tomsim/DivGMX/README.md

# DivGMX
Устройство расширения аппаратных возможностей ZX Spectrum и клонов

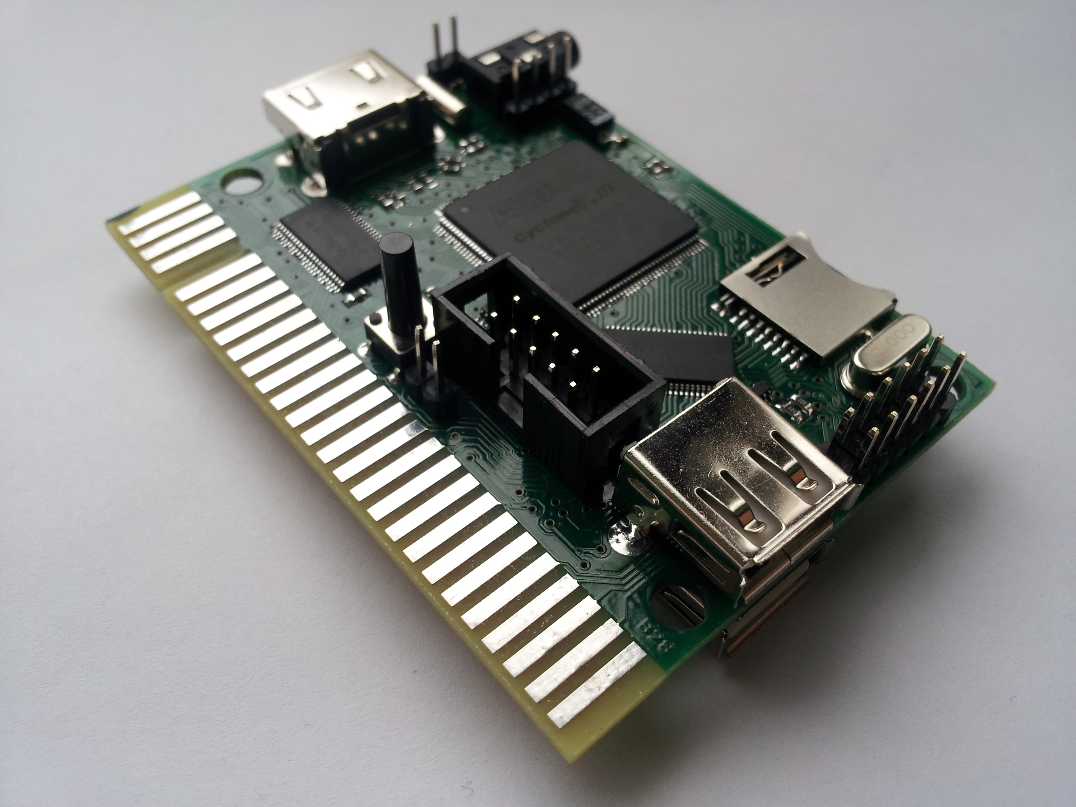
[picture p1: divgmx_board/images/divgmx_brd.png]


DivGMX представляет собой универсальное устройство для установки в слот ZX BUS и основанное на программируемой логической матрице (ПЛИС), обладает гибкой архитектурой, что позволяет проводить обновление и расширение аппаратных возможностей своего ZX Spectrum или клона простой заменой конфигурации.

####Назначение устройства:
- Удобство и комфорт от работы с новой периферией
- Простое подключение ZX Spectrum и его клонов к современному ТВ или монитору через HDMI
- Подключение USB клавиатуры
- Подключение USB мыши
- Подключение USB Gamepad
- Работа с файлами на microSD
- Расширение аппаратных возможностей без паяльника
- Расширение звуковых возможностей
- Расширение графических возможностей
- Обучение работы с ПЛИС
- Возможность создать своё уникальное устройство
- Возможность автономной работы
- Возможность объединения нескольких устройств
- Использование в системах промышленной автоматики
- Возможность подключения Shilds от Arduino через адаптер
- ...

####Спецификация:
- ПЛИС Altera Cyclone III EP3C10 (Cyclone III EP3C5/EP3C10 или Cyclone IV EP4CE6/EP4CE10)
- SDRAM 32MB х 8 bit (4/8/16/32MB х 8 bit)
- SPI FLASH 64Mb (16/32/64Mb)
- RTC DS1338Z
- HDMI
- VNC2 2x USB 2.0 Host контроллер (6 GPIO/SPI/V2Debug)
- microSD
- JTAG
- I2C
- Button NMI, RESET
- Аудио Stereo разъем
- Слот ZX-BUS
- Размер платы 74 х 54 мм

####Совместимость:
- ZX-BUS
- Nemo-BUS

####Возможность аппаратно воспроизвести:
- MSX
- NES
- Orion
- Pentagon 128K, 256K, 512K, 1024K
- Spetsialist_MX
- TS-Conf
- Vector 06cc
- ZX Spectrum 16K, 48К, 128К, +2, +2A, +2B, +3
- Башкирия 2М
- Львов
- Радио 86рк
- ЮТ-88
- ...

####Поддержка в конфигурациях:
- CMOS (стандарт Mr. Gluk)
- DivMMC
- DMA Ultra Sound Card
- Data-Gear
- Gamepad
- General Sound
- Kempston joystick
- Kempston mouse
- Multiface
- ZX Interface 2
- SounDrive
- Turbo Sound
- Z-Controller
...
