tomsim/DivGMX/divgmx_board/images/DivGMX_box.jpg

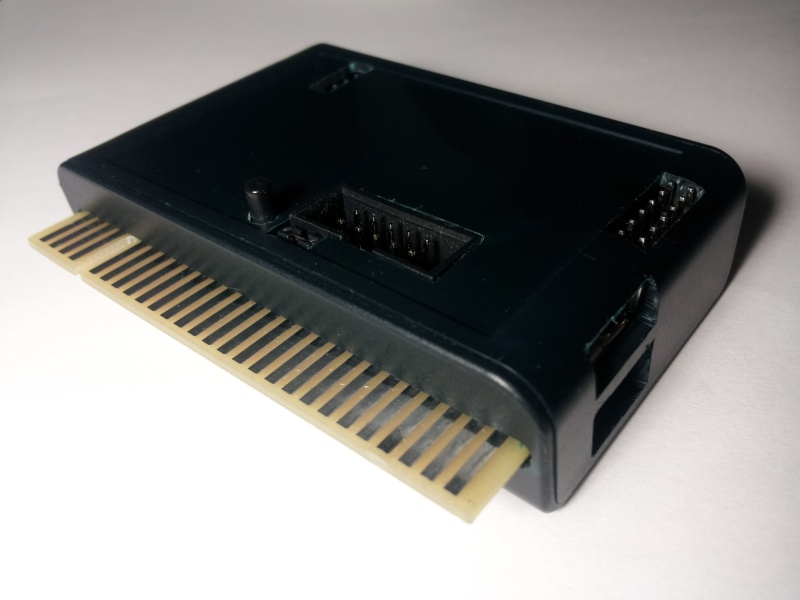
divgmx_board/images/DivGMX_box.jpg
