tomsim/DivGMX/divgmx_board/images/divgmx_sch_eagle.png

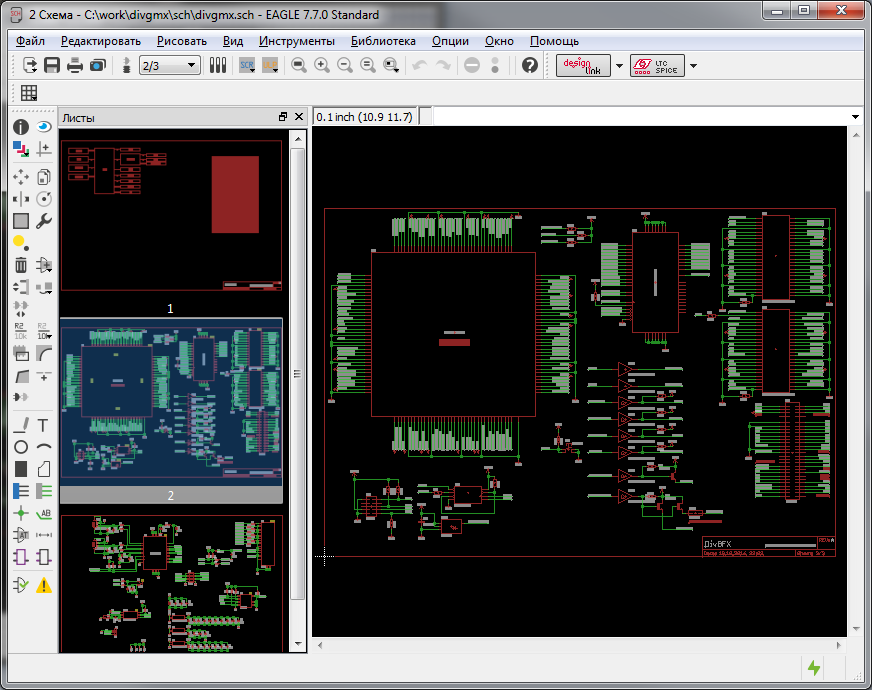
divgmx_board/images/divgmx_sch_eagle.png
