tomsim/DivGMX/divgmx_test_ram/README.md

# Тест 128К
Конфигурация для DivGMX, тестирующая ОЗУ 46К/128К ZX Spectrum и клонов.

Вывод A25 (X1) нужно изолировать (можно наклеить тонкую полоску скотча) и установить перемычку JP1 для возможности отключения ROM на плате ZXM-Phoenix 1024K REV01.
