tomsim/DivGMX/divgmx_board/manuals/divgmx_sch_rev_a.pdf

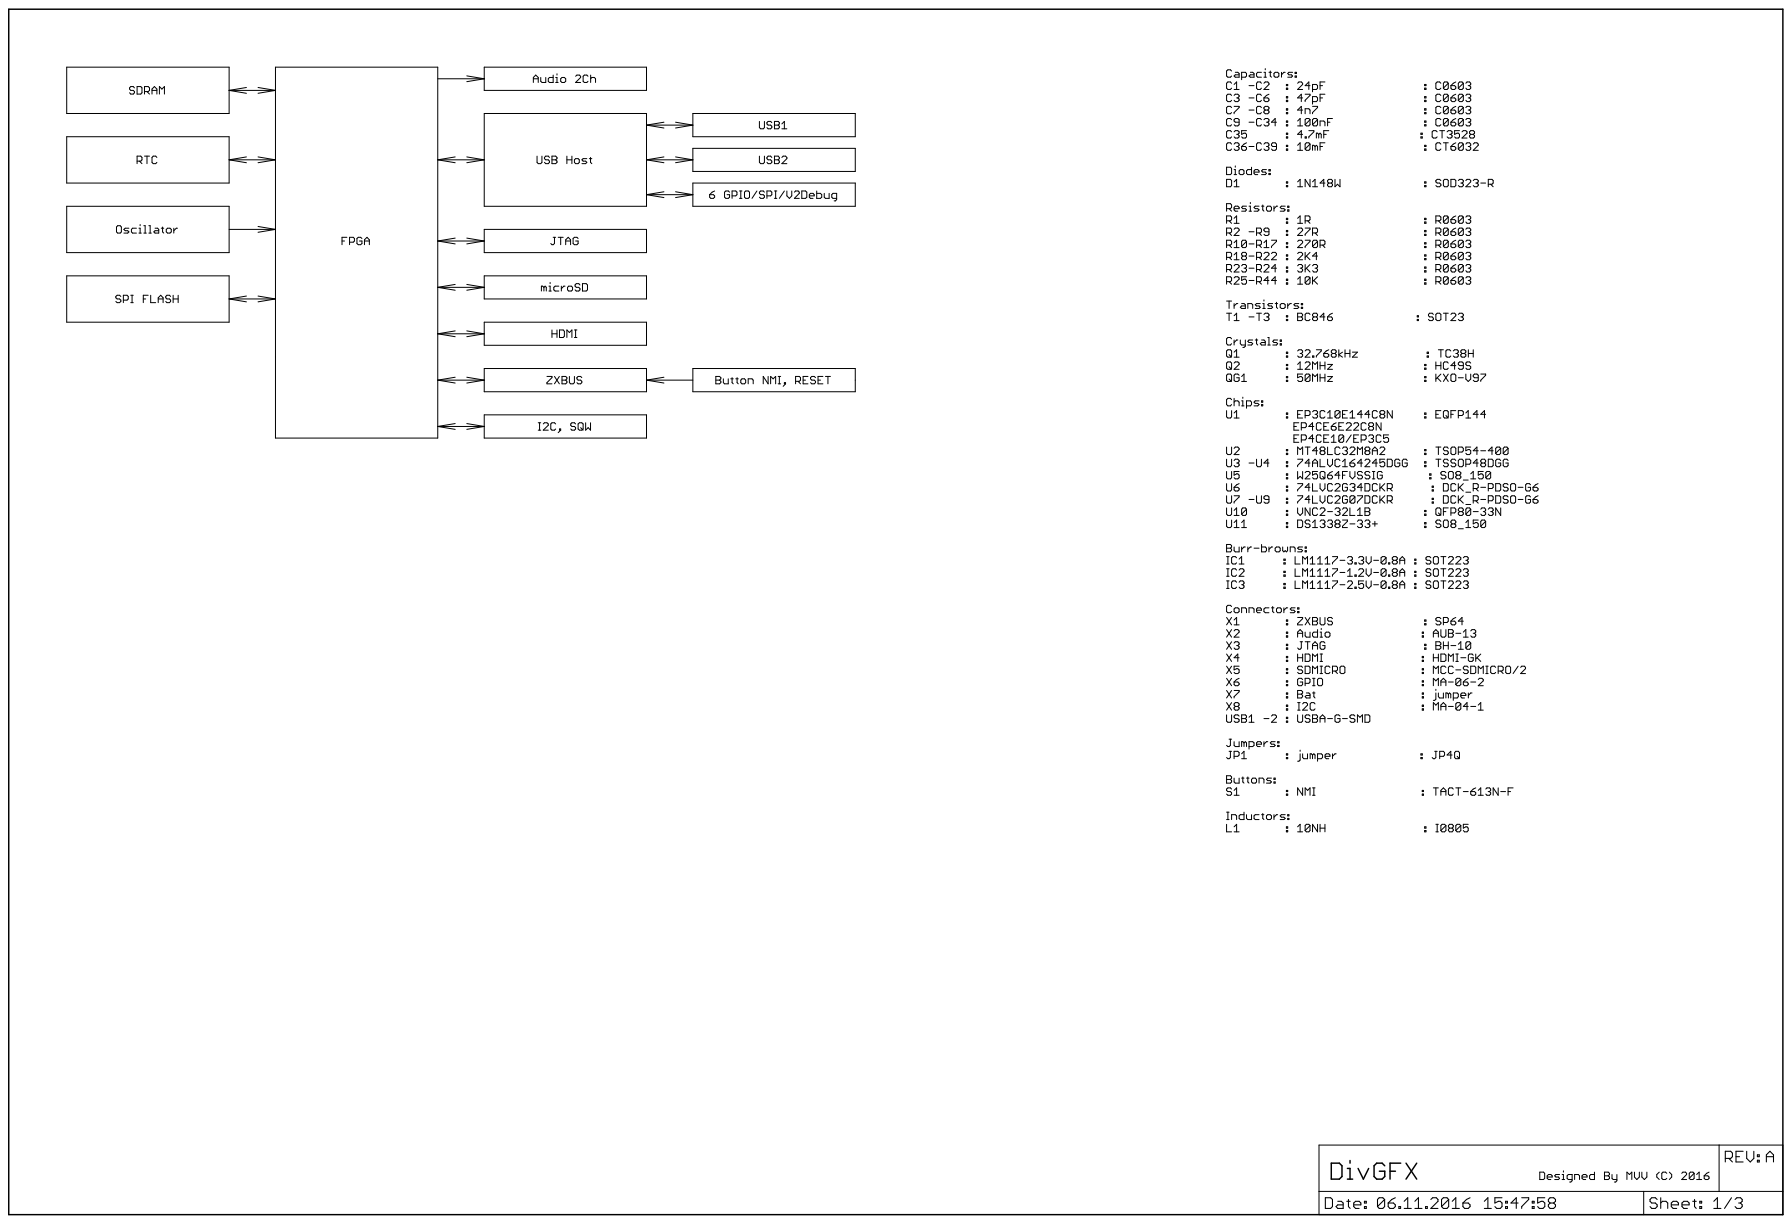
[picture p9: page 1]

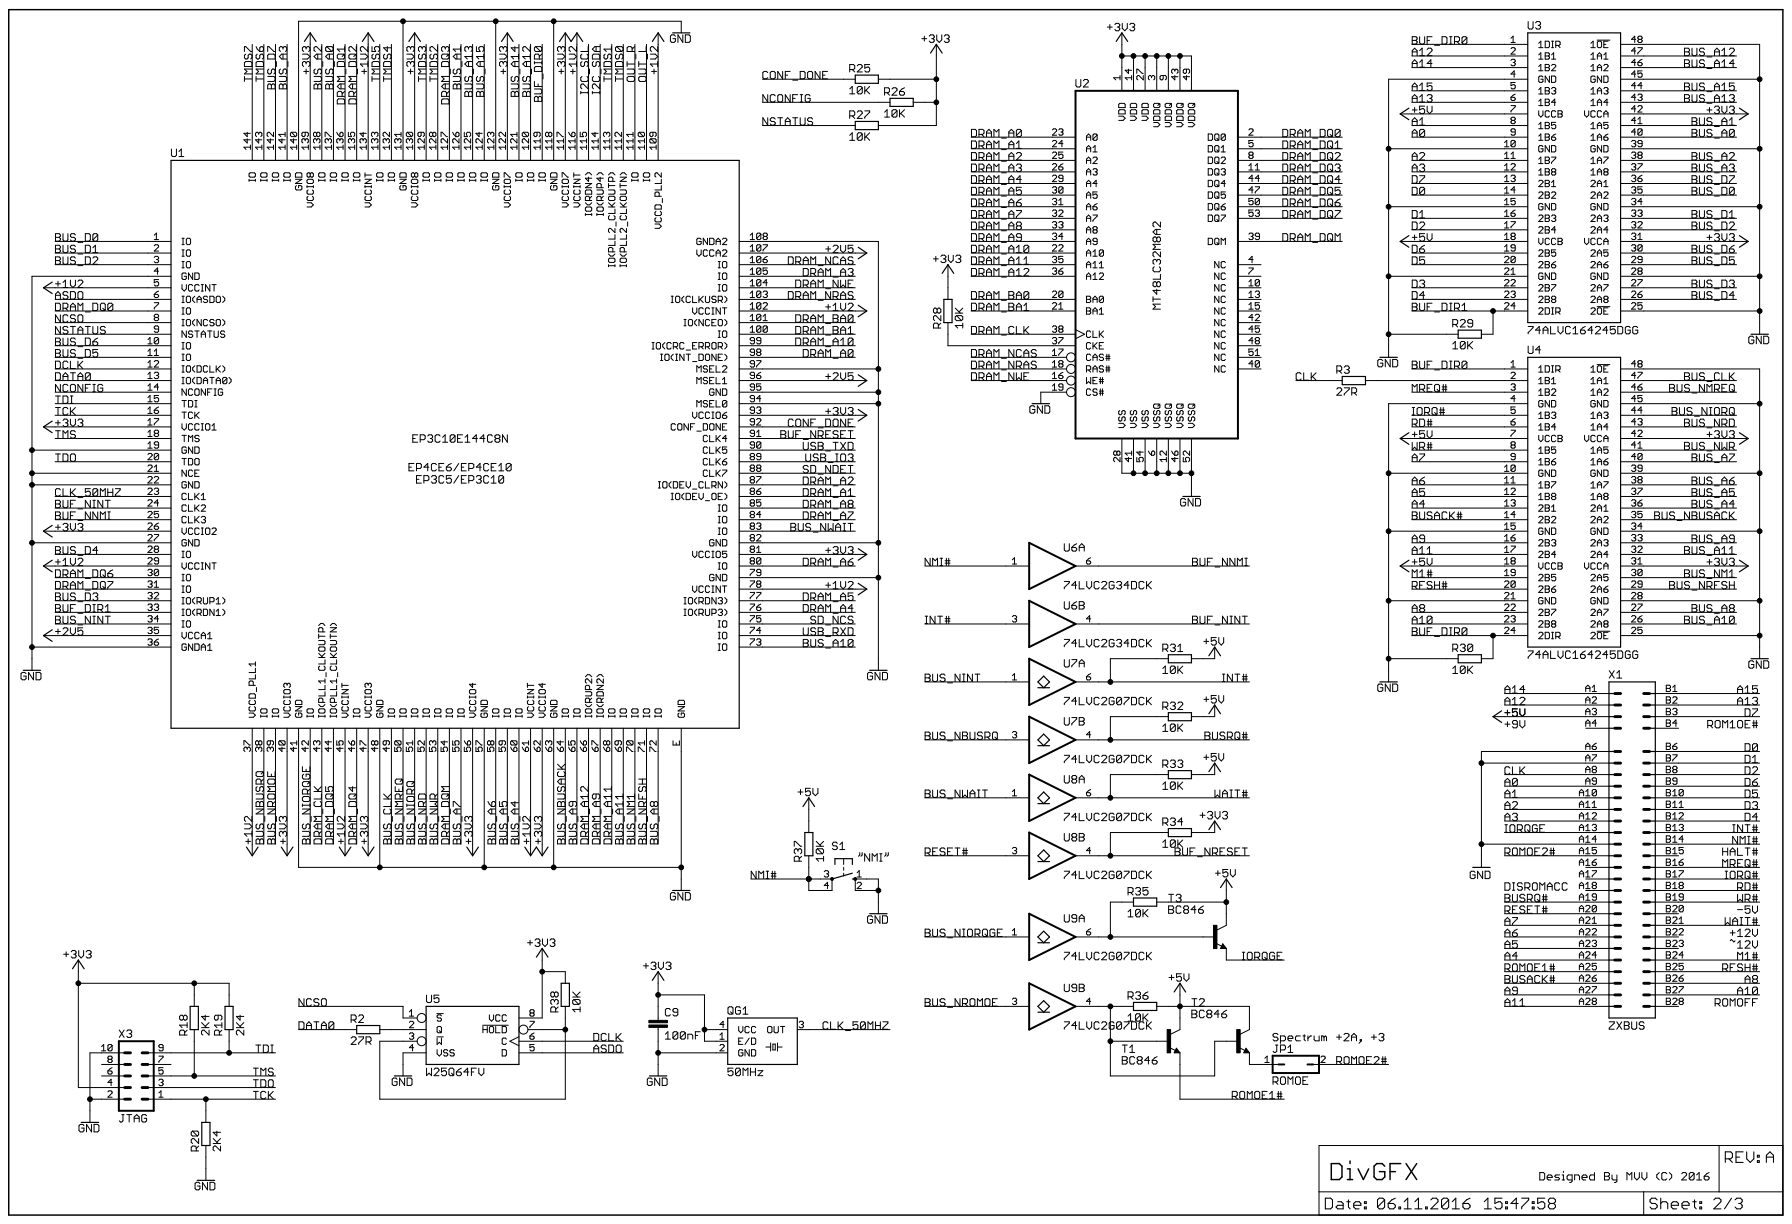
[picture p10: page 2]

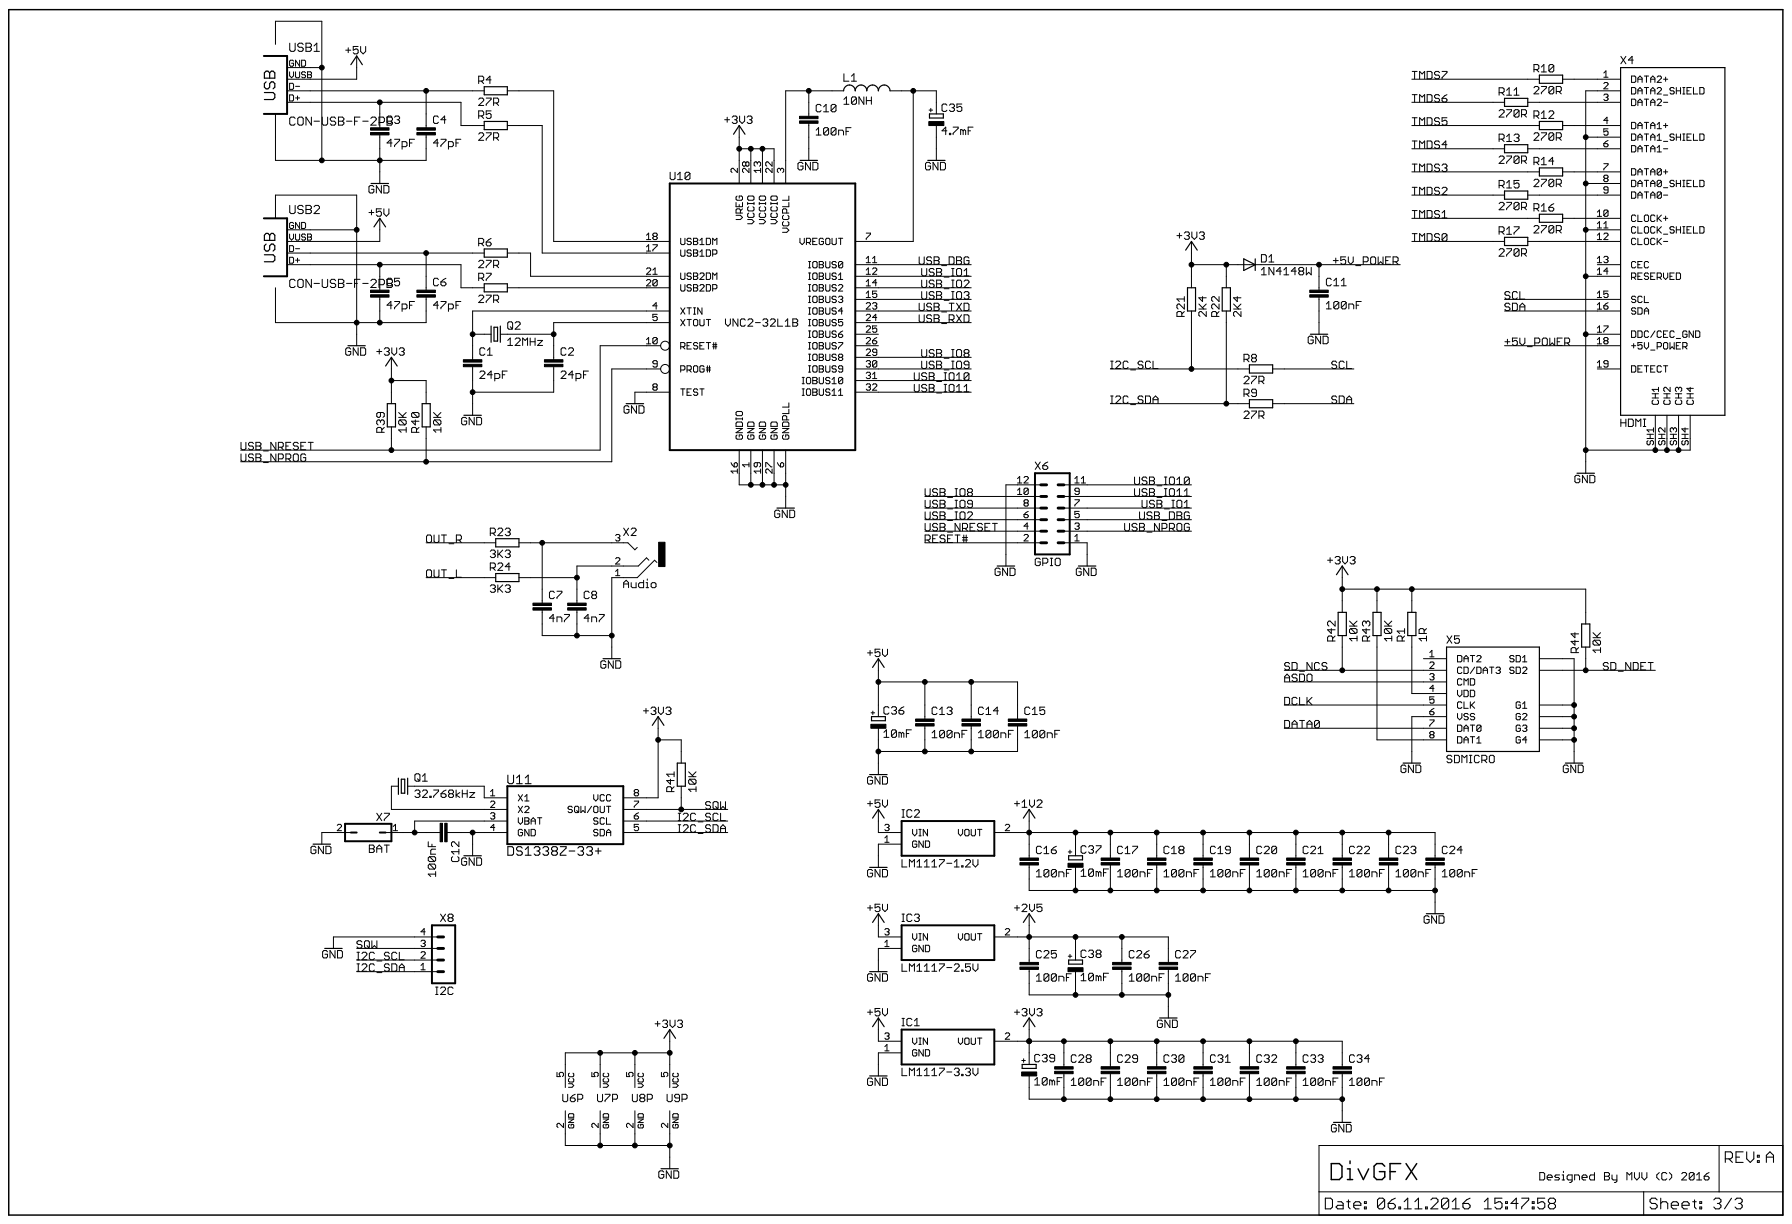
[picture p11: page 3]

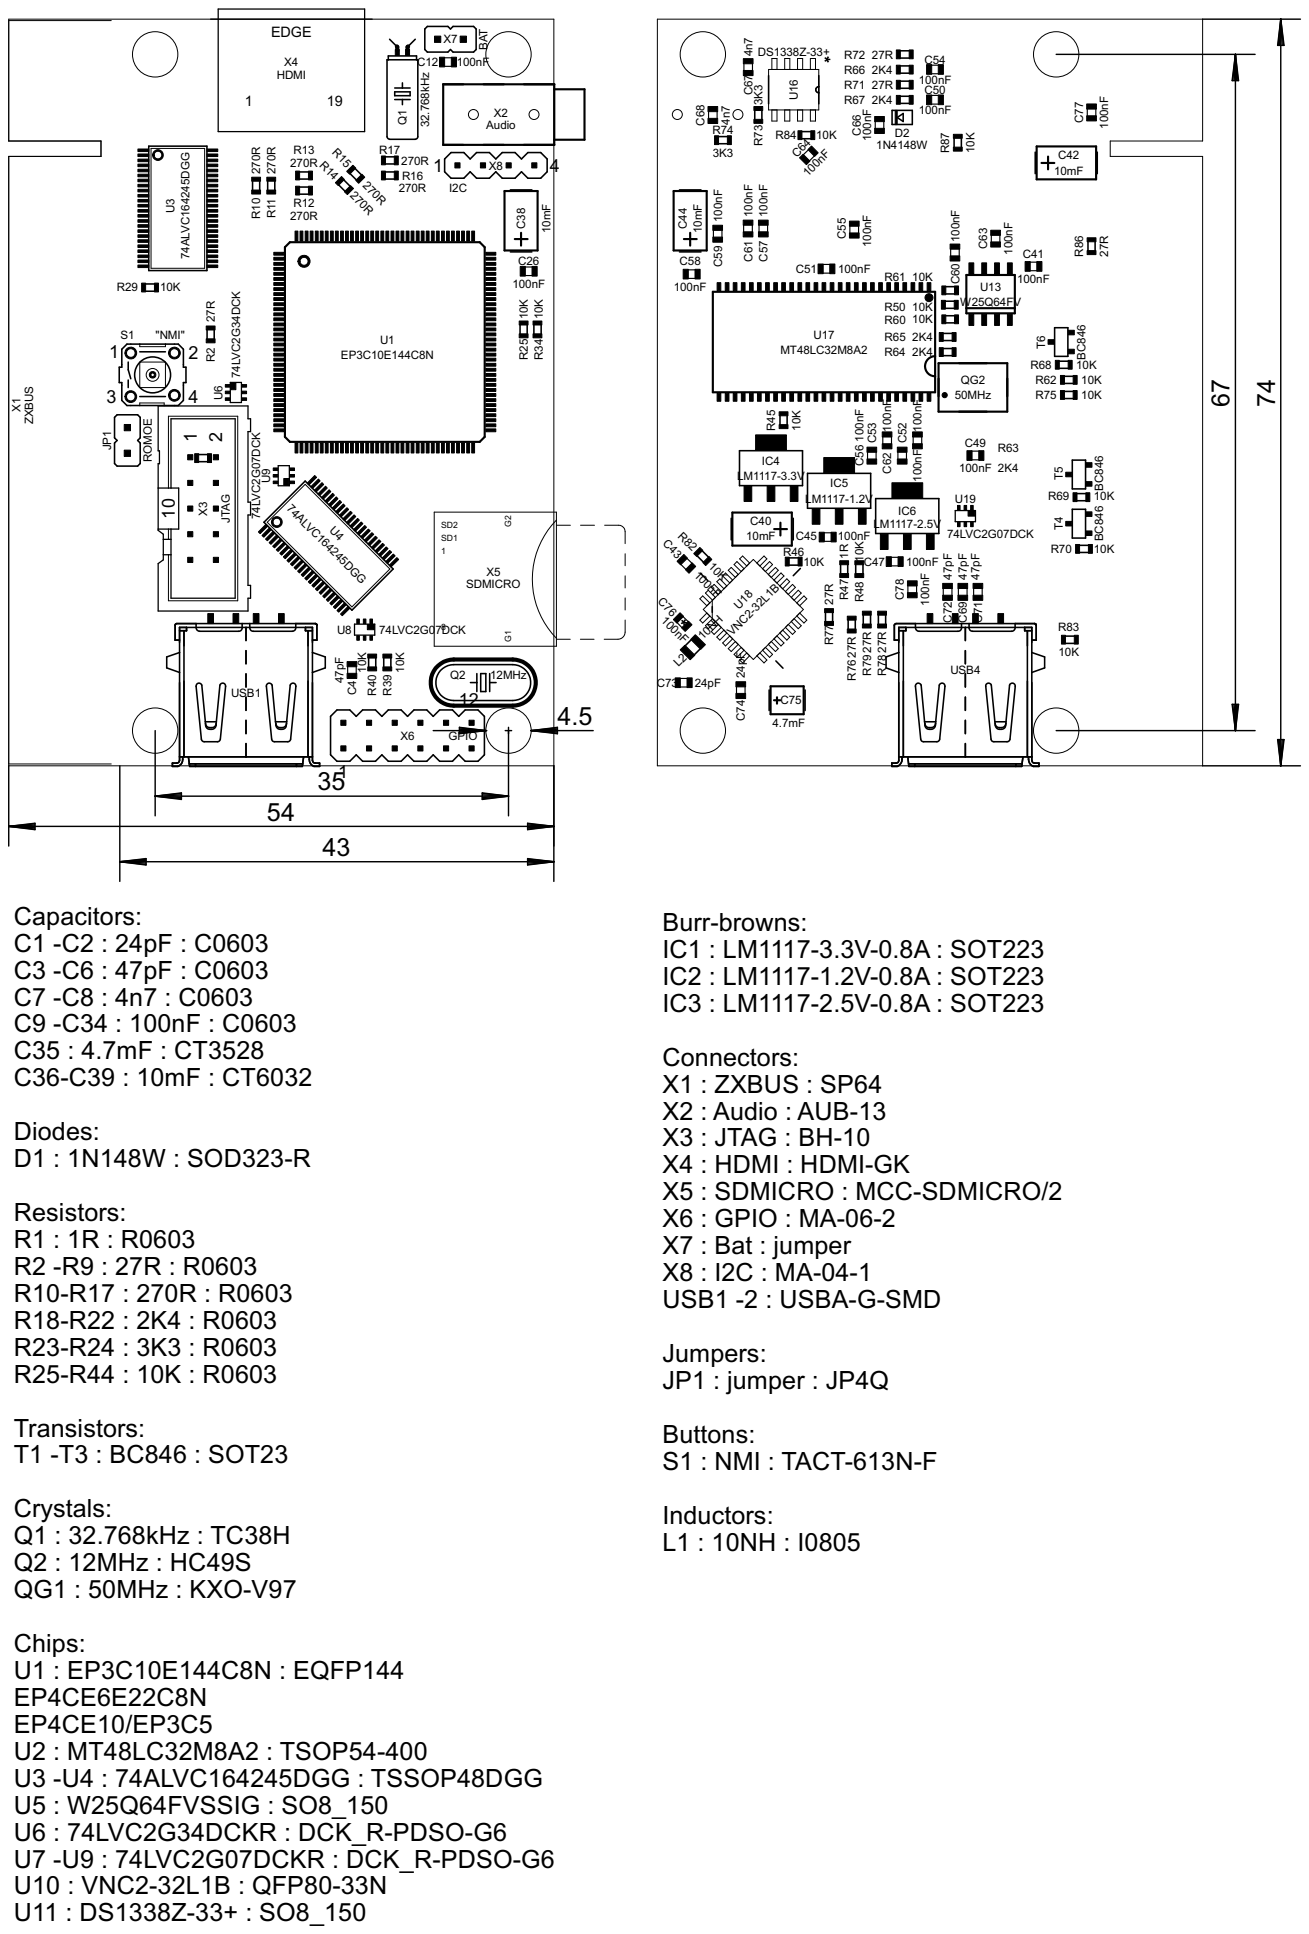
[picture p12: page 4]
