tomsim/DivGMX/(commit log)

2016-10-19 Добавил изображение платы и корпуса
2016-10-19 Заменил изображение divgmx_sch_eagle.bmp на png
2016-11-04 Добавил фото платы
2016-11-06 Добавил Test HDMI
2016-11-15 Добавил схему DivGMX и руководство rev2016
2016-11-15 Revert "Добавил схему DivGMX и руководство rev2016"
    This reverts commit 1d243a4fb6e76de5eb968e78834d8da62e818470.
2016-11-19 Добавил схему и руководство
2016-11-22 Фото теста DivGMX в плате ZXM-Phoenix 1024K REV.01
2016-11-22 Первая сборка конфигурации Basic
    Вывод изображения со звуком на HDMI, тест памяти, JP1 установлен, T1 не
    установлен или сигнал ROMOE1# изолирован на разъеме.
2016-11-29 Фото платы DivGMX в корпусе
2016-11-29 Базовая конфигурация (build 20161127)
2016-11-29 Тест памяти (build 20161122)
